AudiA420T/ESP32-Doorbell-Buzzer/previousversions/v3.md

This was the second attempt at a PCB version that fixed many of the previous issues previously faced.

Changes Made:
- Fixed all traces with issues
- Moved ESP32 female headers from vertical to horizontal to save space
- Removed extra unneccessary resistor on optocoupler circuit
- Removed unneccessary potentiometer

Main Components:
1. ESP32 Module
2. Custom PCB including Relay, Buck Converter, & Optocoupler
3. Blynk Integration for Push Messages / App to trigger the relay





Issues:
- Female header pins were incorrectly spaced for ESP32 (didn't cause an issue completely, but needed to be fixed)
- With the current buck converter design, the door cannot be "buzzed" for a long time, leading to people missing their chance to open the door
