AudiA420T/ESP32-Doorbell-Buzzer/previousversions/v1.md

Version 1 was for testing whether I could put together a system that could achieve the goals I wanted.

Features:
- Sending a push message when someone buzzes.
- Allowing you to buzz your door to let that person in.

Main Components:
1. ESP32 Module
2. Buck Converter Module
3. Relay Module
4. Separate Breadboard with the Optocoupler



Custom enclosure for the ESP32, Relay Board, & Buck Converter



Issues:

- The system was too large and had too many wires.
