AudiA420T/ESP32-Doorbell-Buzzer/src (v4)/DoorBuzzer.pdf

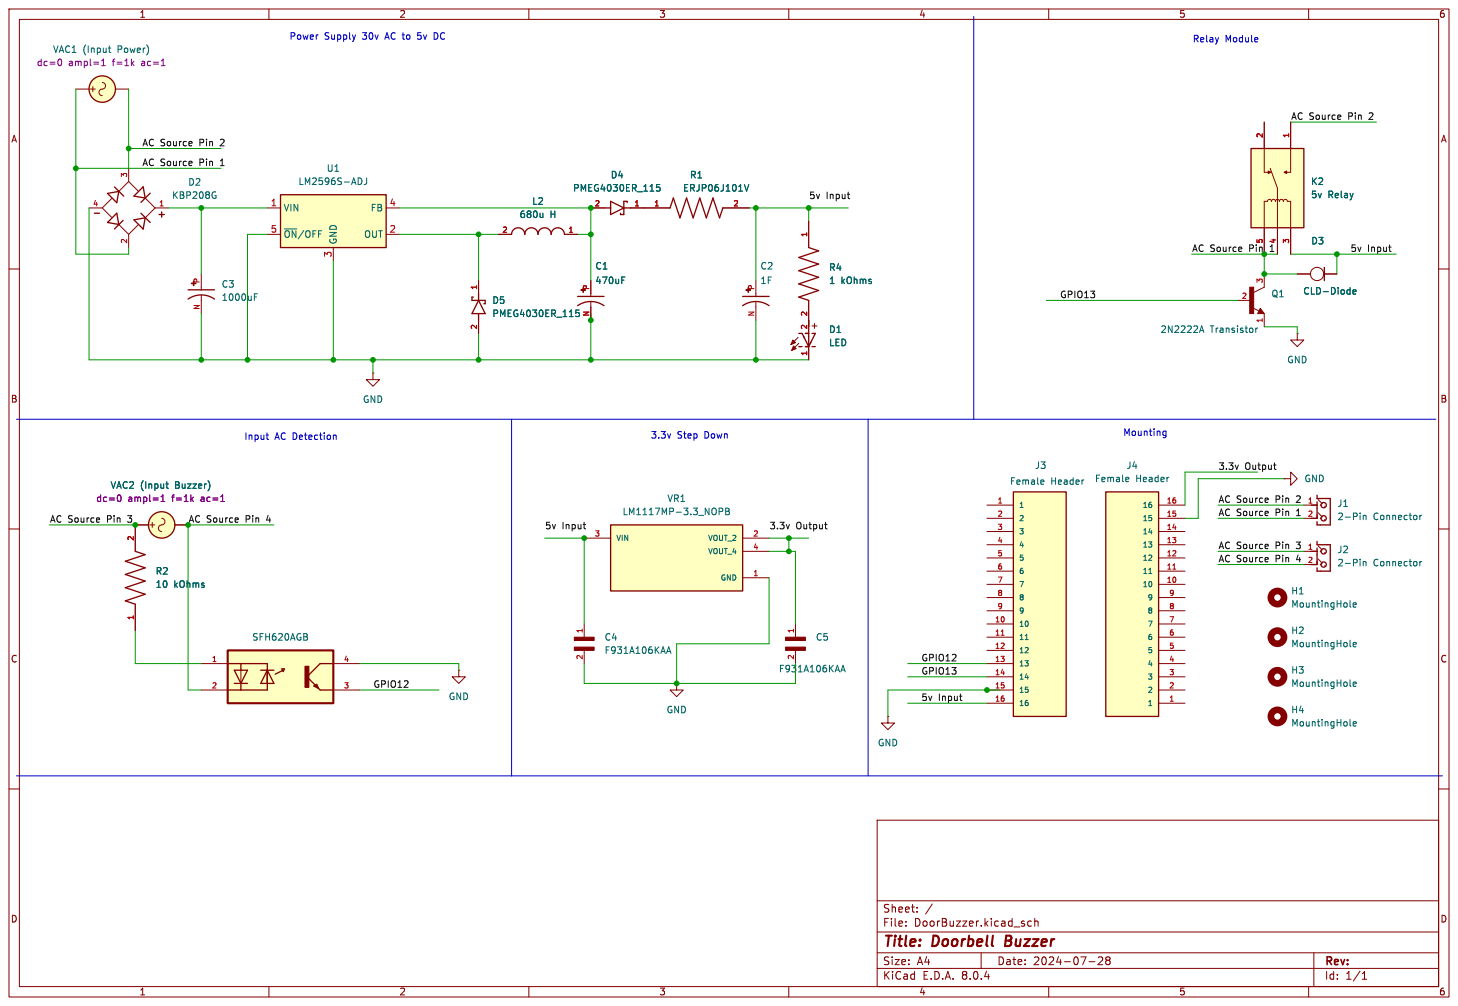
[picture p1: page 1]

+ VAC1 (Input Power) dc=0 ampl=1 f=1k ac=1 GND 1 VOUT_2 2 VIN 3 VOUT_4 4 VR1

AC Source Pin 2 AC Source Pin 1

+ VAC2 (Input Buzzer) dc=0 ampl=1 f=1k ac=1

AC Source Pin 4 AC Source Pin 3 AC Source Pin 2 GPIO12

Id: 1/1 Title: Doorbell Buzzer File: DoorBuzzer.kicad_sch Sheet: /
