AudiA420T/ESP32-Doorbell-Buzzer/(commit log)

2024-07-09 Create blynkdoorbuzzerwrelay.ino
    Adding Arduino file
2024-07-13 Cleaned up code, added WiFi check
    Noticed a few rare times where the unit went offline. Put in a WiFi check. Also cleaned up the timers to align with Blynk
2024-12-29 Added versions to the PCB pic
2024-12-29 Adding in all previous versions
    [Component_List.csv]
2025-01-30 added picture of assembled v4
2025-01-30 assembled v4v2
2025-02-12 Added issues with current v4 board
